TomWhitwell/Mikrophonie/README.md

# Mikrophonie

Design files for the Music Thing Modular Mikrophonie Module.  

Full details available at http://www.musicthing.co.uk
