TomWhitwell/Mikrophonie/Hardware/Mikrophonie_2023/Panel/Kicad/mikrophonie_v2_PCB_proto1.png

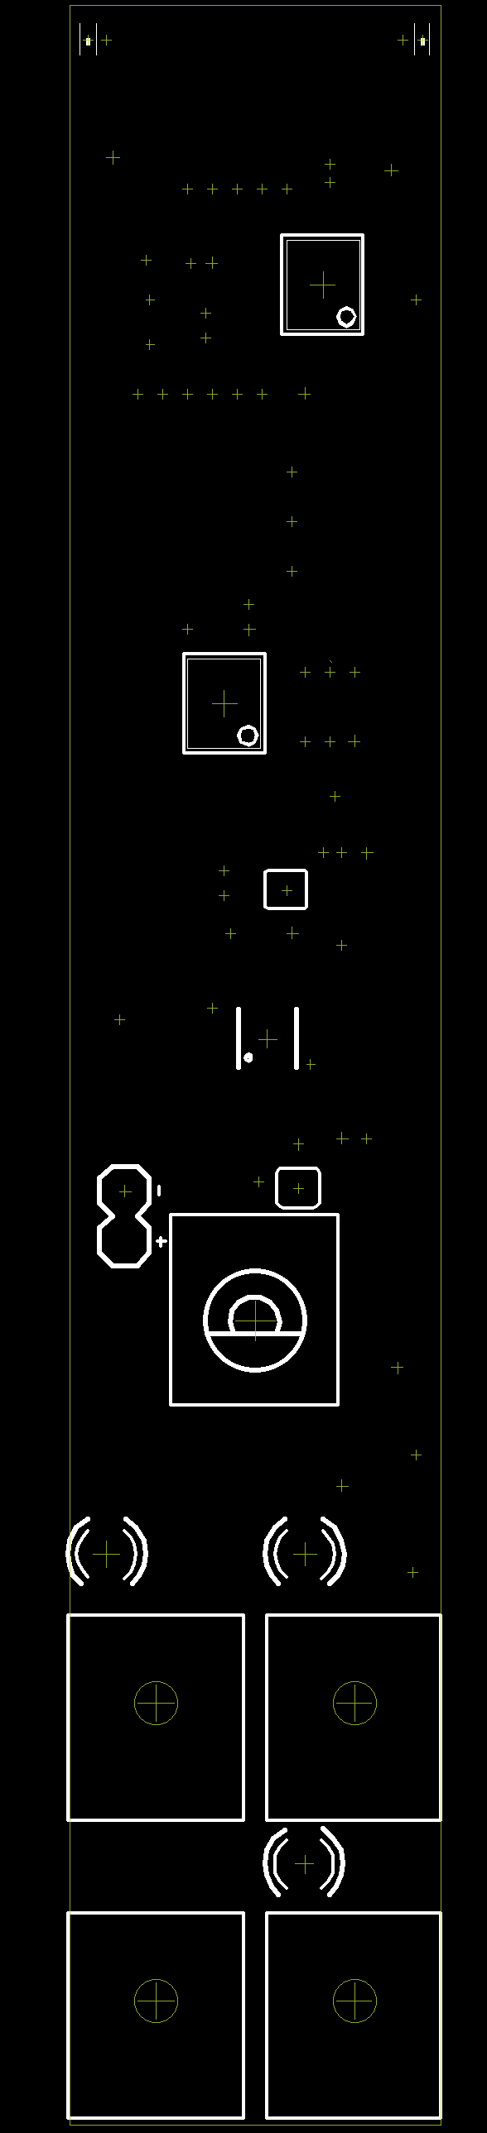
Hardware/Mikrophonie_2023/Panel/Kicad/mikrophonie_v2_PCB_proto1.png
