TomWhitwell/Mikrophonie/Collateral/Mikrophonie-Schematic.pdf

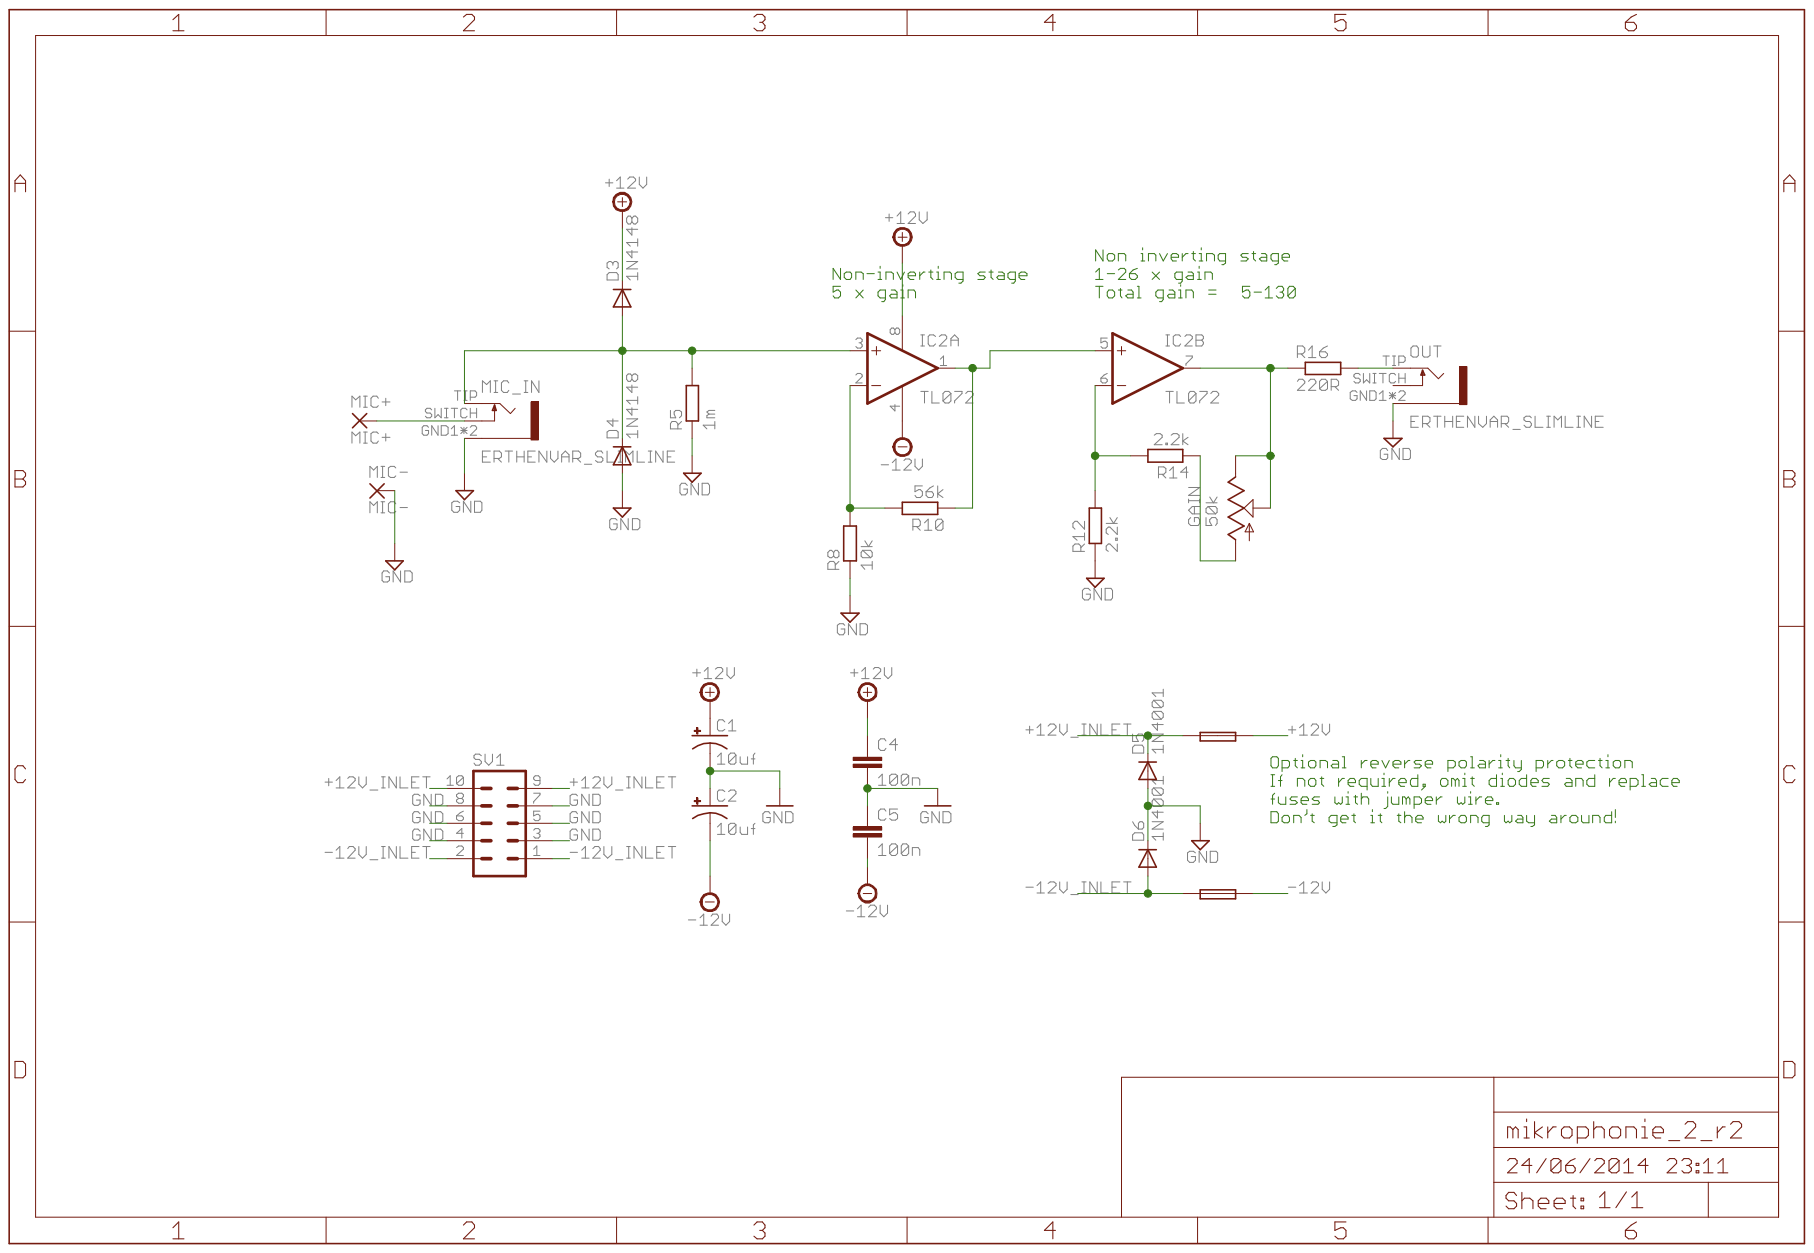
[picture p2: page 1]
