TomWhitwell/Mikrophonie/Hardware/Mikrophonie_2023/mikrophonie_2023-Schematic.pdf

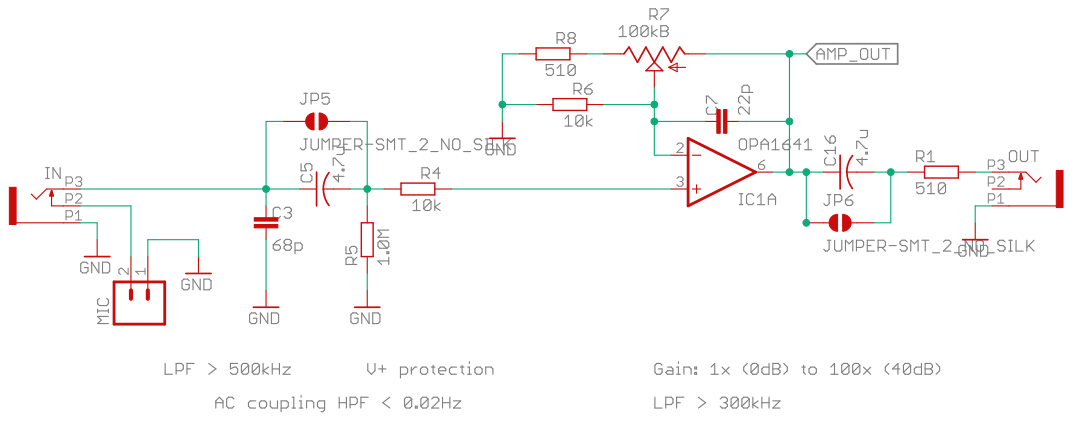
[picture p3: page 1]

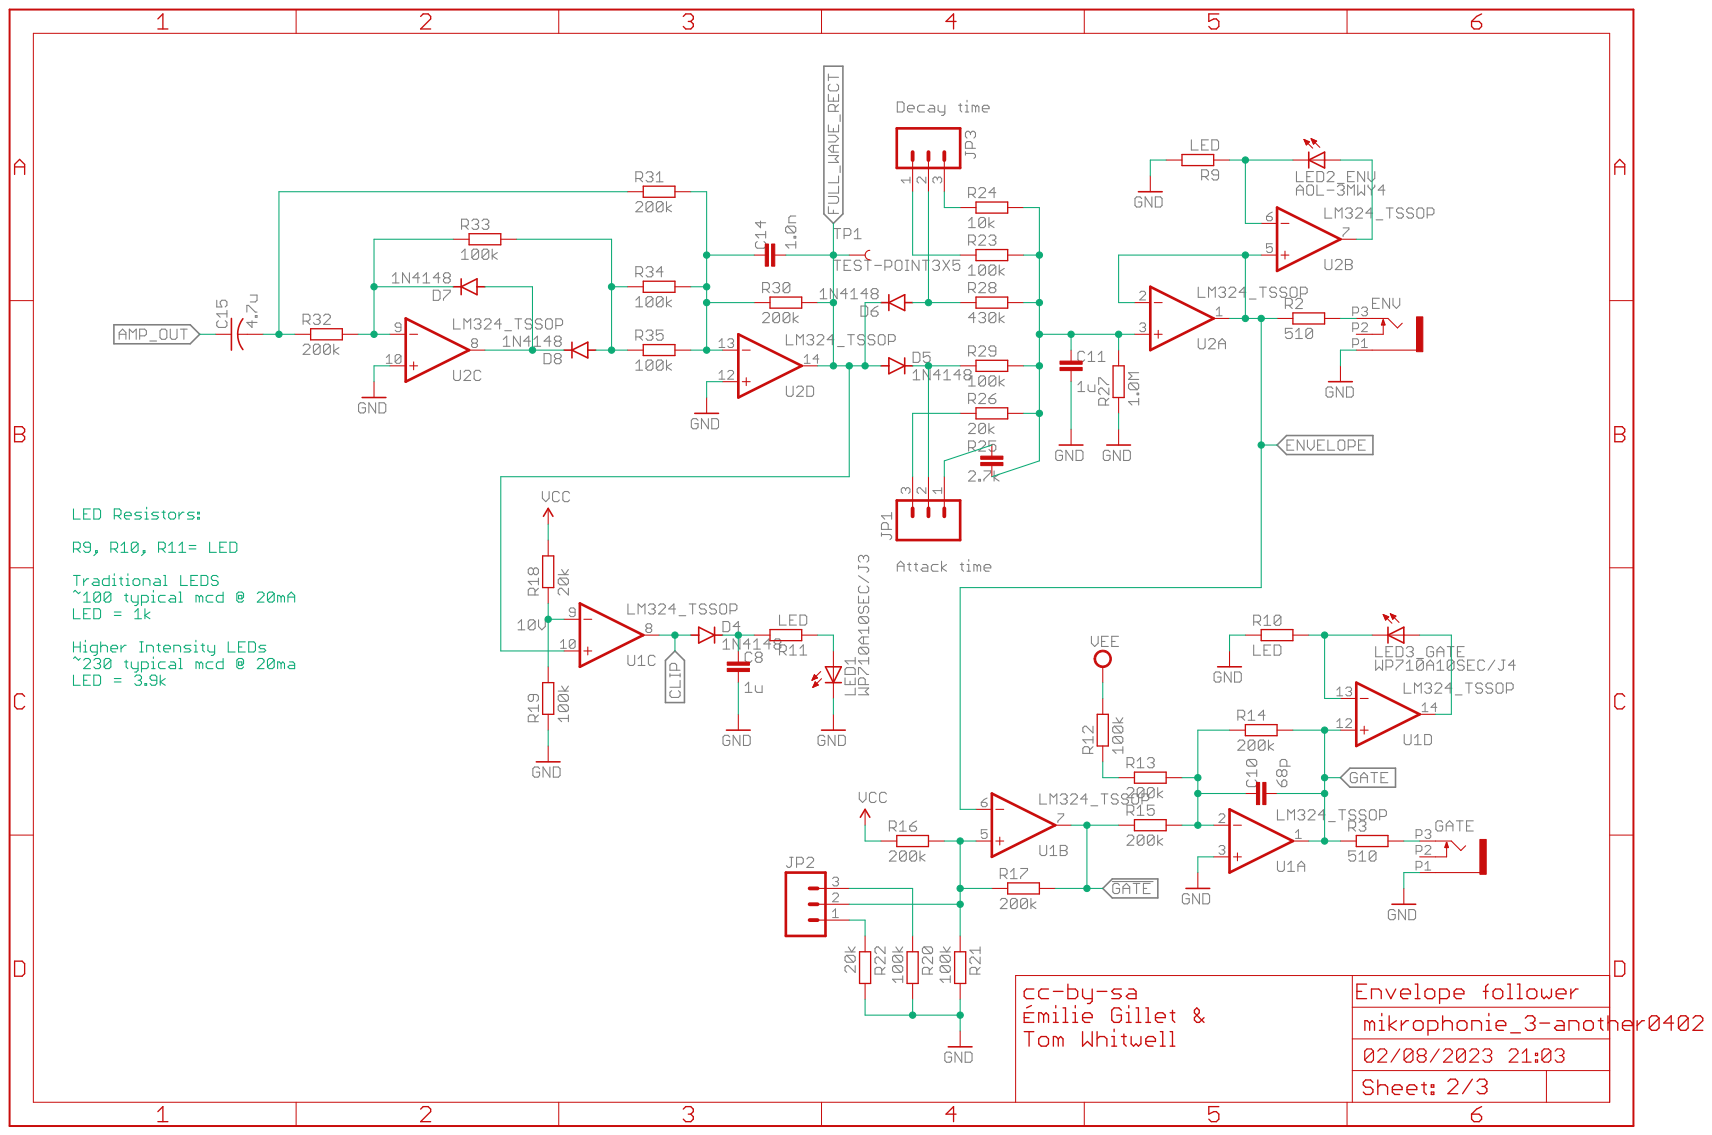
[picture p4: page 2]

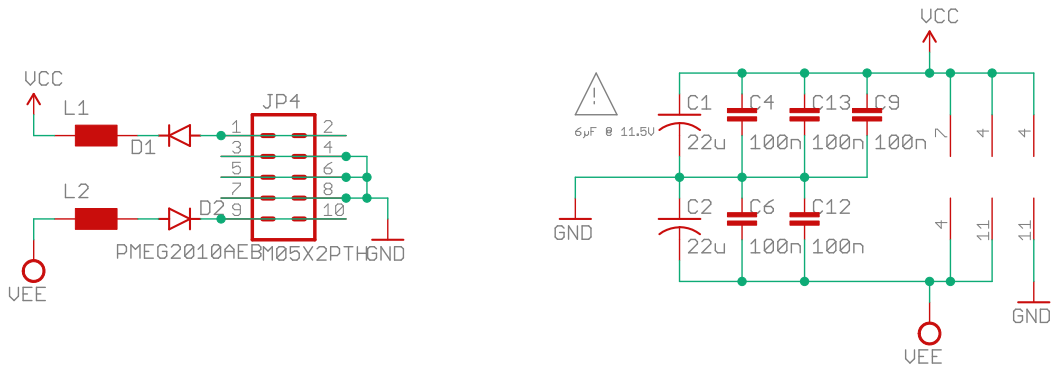
[picture p5: page 3]
