TomWhitwell/Mikrophonie/Hardware/Mikrophonie_2023/mikrophonie_2023.brd

## EAGLE design Hardware/Mikrophonie_2023/mikrophonie_2023.brd (2023-10-18)


Parts:
C3: 68p; C0402-90
C5, C16: 4.7u; C0603
C7: 22p; C0402-90
IC1: OPA1641; MSOP8
IN: PJ301_THONKICONN6; WQP_PJ_301M6
JP5, JP6: JUMPER-SMT_2_NO_SILK; SMT-JUMPER_2_NO_SILK
MIC: M02TINY; 1X02_TINY
OUT: PJ301_THONKICONN6; WQP_PJ_301M6
R1, R8: 510; C0402-90
R4, R6: 10k; C0402-90
R5: 1.0M; C0402-90
R7: 100kB; ALPS_POT_VERTICAL_PS

Connections:
AMP_OUT: C7.2, C16.1, IC1.6 (OUT), JP6.1, R7.P$3 (A); also elsewhere on the board
GND: C3.2, IN.P1 (1), MIC.1, OUT.P1 (1), R5.1, R6.2, R8.2; also elsewhere on the board
unnamed: IC1.3 (+IN), R4.1
unnamed: OUT.P3 (3), R1.2
unnamed: C3.1, C5.1, IN.P3 (3), JP5.1
unnamed: IN.P2 (2), MIC.2
unnamed: C7.1, IC1.2 (-IN), R6.1, R7.P$2 (S)
unnamed: C5.2, JP5.2, R4.2, R5.2
unnamed: R7.P$1 (E), R8.1
unnamed: C16.2, JP6.2, R1.1

Notes on the sheet:
cc-by-sa
Input amplifier
Gain: 1x (0dB) to 100x (40dB)
LPF > 500kHz
V+ protection
LPF > 300kHz
AC coupling HPF < 0.02Hz
Émilie Gillet & Tom Whitwell


Parts:
C8, C11: 1u; C0402-90
C10: 68p; C0402-90
C14: 1.0n; C0402-90
C15: 4.7u; C0603
D4, D5, D6, D7, D8: 1N4148; SOD523
ENV: PJ301_THONKICONN6; WQP_PJ_301M6
GATE: PJ301_THONKICONN6; WQP_PJ_301M6
JP1, JP2, JP3: M03PTH; 1X03
LED1: WP710A10SEC/J3; LED3MM
LED2_ENV: AOL-3MWY4; LED3MM
LED3_GATE: WP710A10SEC/J4; LED3MM
R2, R3: 510; C0402-90
R9, R10, R11: LED; C0402-90
R12, R19, R20, R21, R23, R29, R33, R34, R35: 100k; C0402-90
R13, R14, R15, R16, R17, R30, R31, R32: 200k; C0402-90
R18, R22, R26: 20k; C0402-90
R24: 10k; C0402-90
R25: 2.7k; C0402-90
R27: 1.0M; C0402-90
R28: 430k; C0402-90
TP1: TEST-POINT3X5; PAD.03X.05
U1, U2: LM324_TSSOP; SOP65P640X120-14N

Connections:
!GATE: R15.1, R17.2, U1.7 (OUT)
AMP_OUT: C15.1; also elsewhere on the board
AMP_OUT_AC: C15.2, R31.1, R32.1
CLIP: D4.A, U1.8 (OUT)
ENVELOPE: R2.1, U1.6 (-IN), U2.1 (OUT), U2.2 (-IN), U2.5 (+IN)
FULL_WAVE_RECT: C14.2, D5.A, D6.C, R30.2, TP1.P$1, U1.10 (+IN), U2.14 (OUT)
GATE: C10.2, R3.1, R14.2, U1.1 (OUT), U1.12 (+IN)
GND: C8.2, C11.2, ENV.P1 (1), GATE.P1 (1), LED1.K (C), R9.2, R10.1, R19.1, R20.2, R21.2, R22.2, R27.1, U1.3 (+IN), U2.10 (+IN), U2.12 (+IN); also elsewhere on the board
unnamed: D7.A, D8.C, U2.8 (OUT)
unnamed: C10.1, R13.2, R14.1, R15.2, U1.2 (-IN)
unnamed: D7.C, R32.2, R33.1, U2.9 (-IN)
unnamed: D8.A, R33.2, R34.1, R35.1
unnamed: C14.1, R30.1, R31.2, R34.2, R35.2, U2.13 (-IN)
unnamed: ENV.P3 (3), R2.2
unnamed: LED2_ENV.K (C), R9.1, U2.6 (-IN)
unnamed: D5.C, JP1.2, R29.1
unnamed: C11.1, R23.2, R24.2, R25.2, R26.2, R27.2, R28.2, R29.2, U2.3 (+IN)
unnamed: JP3.3, R24.1
unnamed: JP3.1, R23.1
unnamed: D6.A, JP3.2, R28.1
unnamed: JP1.1, R25.1
unnamed: JP1.3, R26.1
unnamed: R18.1, R19.2, U1.9 (-IN)
unnamed: C8.1, D4.C, R11.2
unnamed: LED2_ENV.A, U2.7 (OUT)
unnamed: LED1.A, R11.1
unnamed: GATE.P3 (3), R3.2
unnamed: JP2.2, R16.2, R17.1, R21.1, U1.5 (+IN)
unnamed: JP2.1, R22.1
unnamed: JP2.3, R20.1
unnamed: LED3_GATE.K (C), R10.2, U1.13 (-IN)
unnamed: LED3_GATE.A, U1.14 (OUT)
unnamed: R12.1, R13.1
VCC: R16.1, R18.2; also elsewhere on the board
VEE: R12.2; also elsewhere on the board

Notes on the sheet:
cc-by-sa
Envelope follower
Decay time
Attack time
10V
Émilie Gillet & Tom Whitwell
LED Resistors: R9, R10, R11= LED Traditional LEDS ~100 typical mcd @ 20mA LED = 1k Higher Intensity LEDs ~230 typical mcd @ 20ma LED = 3.9k


Parts:
C1, C2: 22u; C1206
C4, C6, C9, C12, C13: 100n; C0402-90
D1, D2: PMEG2010AEB; SOD523
IC1: OPA1641; MSOP8
JP4: M05X2PTH; AVR_ICSP
L1, L2: WE-CBF_0603; 0603
U1, U2: LM324_TSSOP; SOP65P640X120-14N

Connections:
GND: C1.2, C2.1, C4.2, C6.1, C9.2, C12.1, C13.2, JP4.3, JP4.4, JP4.5, JP4.6, JP4.7, JP4.8, U1.11 (V-); also elsewhere on the board
unnamed: D1.A, JP4.1, JP4.2
unnamed: D2.C, JP4.9, JP4.10
unnamed: D1.C, L1.2
unnamed: D2.A, L2.2
VCC: C1.1, C4.1, C9.1, C13.1, IC1.7 (V+), L1.1, U1.4 (V+), U2.4 (V+); also elsewhere on the board
VEE: C2.2, C6.2, C12.2, IC1.4 (V-), L2.1, U2.11 (V-); also elsewhere on the board

Notes on the sheet:
cc-by-sa
Power supply
6µF @ 11.5V
Émilie Gillet & Tom Whitwell

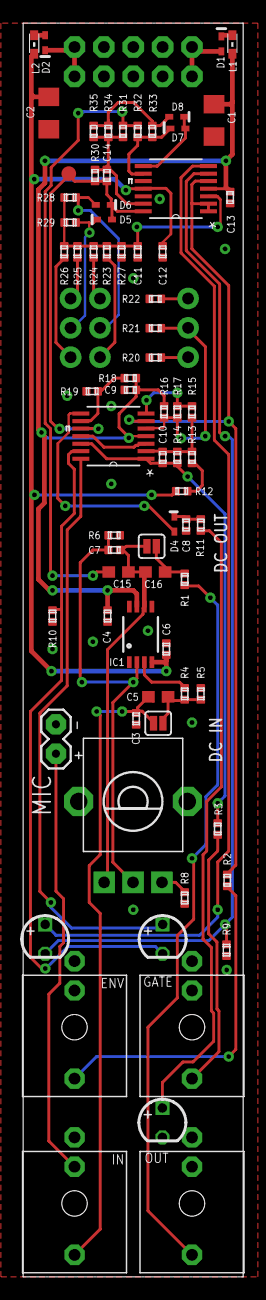
[picture p9: board mikrophonie_2023.brd from above]

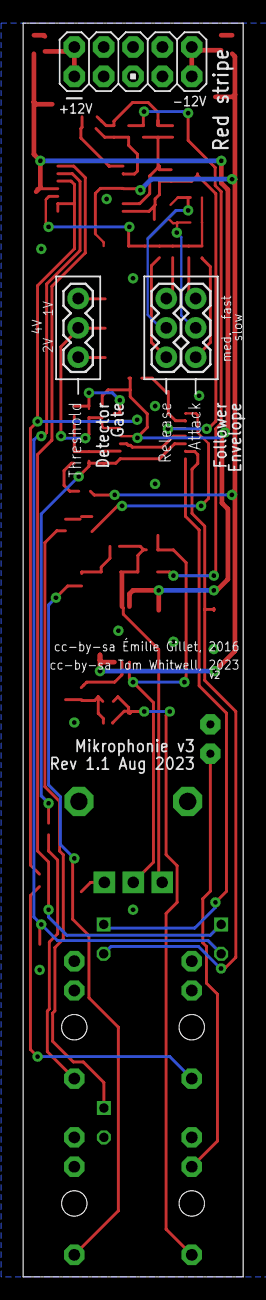
[picture p10: board mikrophonie_2023.brd from below]

Board: 2 copper layers, 19.0 x 108.4 mm, 78 parts (4 on the bottom side), 47 nets.
