TomWhitwell/Mikrophonie/Hardware/Mikrophonie_2014/Mikrophonie_2_2_egl/mikrophonie_2_r2.brd

## EAGLE design Hardware/Mikrophonie_2014/Mikrophonie_2_2_egl/mikrophonie_2_r2.brd (2018-01-01)

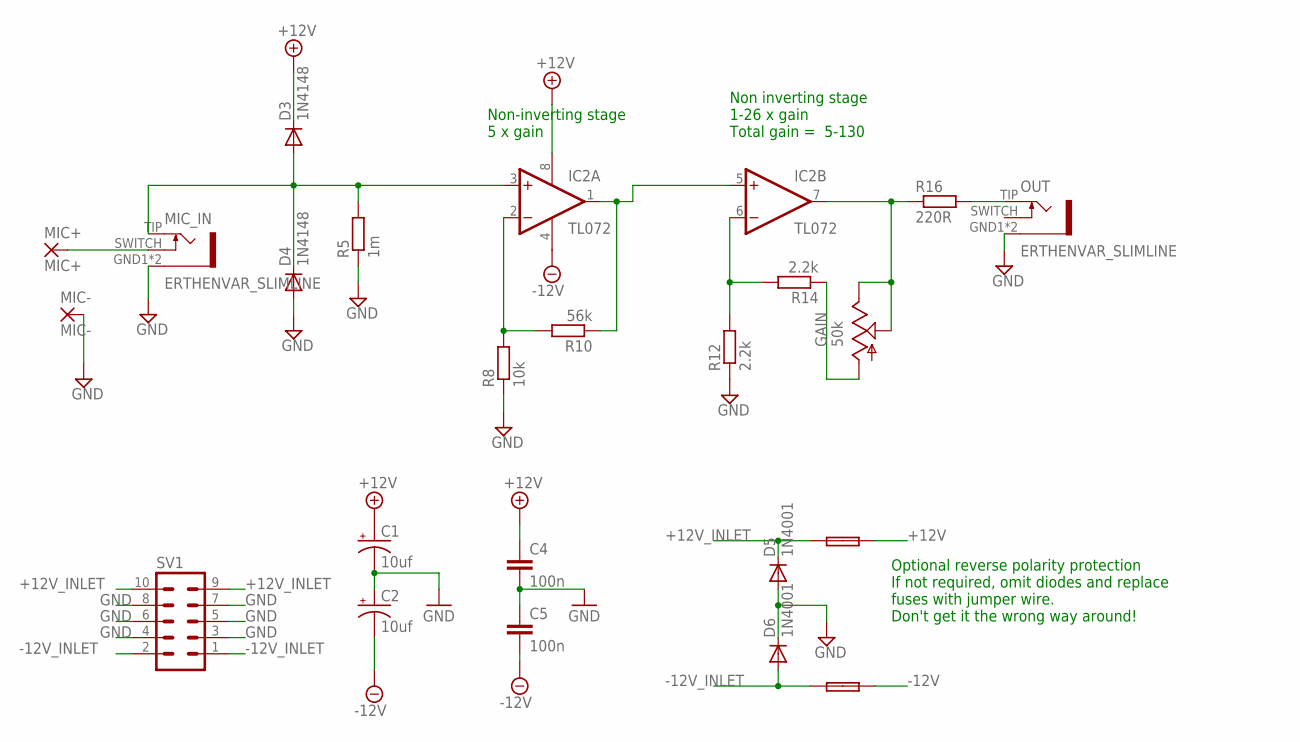
[picture p11: schematic mikrophonie_2_r2.sch]

Parts:
1: FUSE; C050H075X075
C1, C2: 10uf; CPOL-RADIAL-10UF-25V
C4, C5: 100n; C050-024X044
D3, D4: 1N4148; DO35-7
D5, D6: 1N4001; DO41-10
FUSE: FUSE; C050H075X075
GAIN: 50k; EVUF
IC2: TL072; DIL08
MIC+: MIC+; LONG_PAD_1
MIC-: MIC-; LONG_PAD_1
MIC_IN: ERTHENVAR_SLIMLINE
OUT: ERTHENVAR_SLIMLINE
R5: 1m; 0207/10
R8: 10k; 0207/10
R10: 56k; 0207/10
R12, R14: 2.2k; 0207/10
R16: 220R; 0207/10
SV1: 10_PIN_HEADER; MA05-2

Connections:
+12V: 1.2, C1.1 (+), C4.1, D3.C, IC2.8 (V+)
+12V_INLET: 1.1, D5.C, SV1.9, SV1.10
-12V: C2.2 (-), C5.2, FUSE.2, IC2.4 (V-)
-12V_INLET: D6.A, FUSE.1, SV1.1, SV1.2
GND: C1.2 (-), C2.1 (+), C4.2, C5.1, D4.A, D5.A, D6.C, MIC-.P$1, MIC_IN.GND1 (5), MIC_IN.GND2 (5), OUT.GND1 (5), OUT.GND2 (5), R5.1, R8.1, R12.1, SV1.3, SV1.4, SV1.5, SV1.6, SV1.7, SV1.8
unnamed: MIC+.P$1, MIC_IN.SWITCH (4)
unnamed: D3.A, D4.C, IC2.3 (+IN), MIC_IN.TIP (3), R5.2
unnamed: IC2.2 (-IN), R8.2, R10.2
unnamed: IC2.1 (OUT), IC2.5 (+IN), R10.1
unnamed: GAIN.1 (A), R14.1
unnamed: IC2.6 (-IN), R12.2, R14.2
unnamed: GAIN.2 (S), GAIN.3 (E), IC2.7 (OUT), R16.1
unnamed: OUT.TIP (3), R16.2

Notes on the sheet:
Non-inverting stage 5 x gain
Non inverting stage 1-26 x gain Total gain = 5-130
Optional reverse polarity protection If not required, omit diodes and replace fuses with jumper wire. Don't get it the wrong way around!

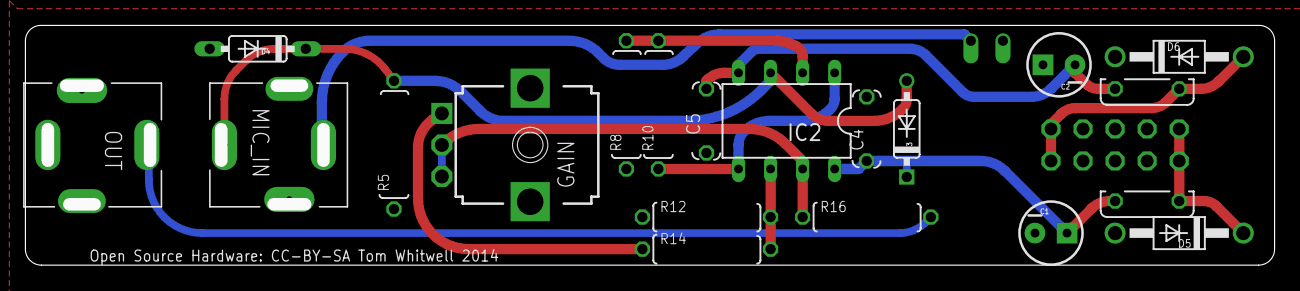
[picture p12: board mikrophonie_2_r2.brd from above]

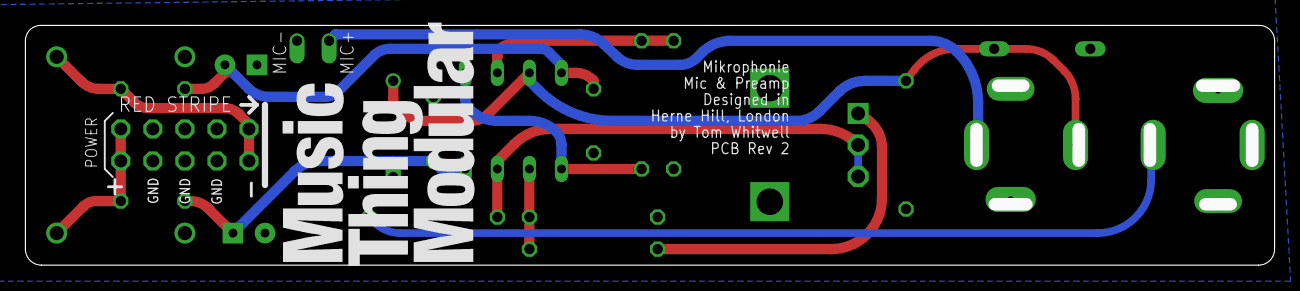
[picture p13: board mikrophonie_2_r2.brd from below]

Board: 4 copper layers, 99.0 x 19.0 mm, 24 parts (2 on the bottom side), 13 nets.

Other parts of the board:
U$2: MTM_2CM_SCREEN_200DPI
