TomWhitwell/Mikrophonie/(threads)

Thread 1 (2022-08-02):

Which type of fuse should be used?

LegendaryTeacherLiu, 2022-08-02:
The model is not marked on the PCB. Can you tell me which model should be useful?

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

benjaminvdb, 2024-12-02:
If you check the module for shorts after building it (continuity between +12/-12, -12/GND or +12/GND means a short) and test the module in isolation (to avoid damaging other modules) then you don't need a fuse, in my opinion. In other words, you can use a wire or clipped lead to short the circuit where the fuse is supposed to go.

The fuse is there as overcurrent protection which is most likely caused by a short. I don't encounter them a lot in Eurorack modules these days. If you really need the additional protection, Radio Music uses [this](https://www.mouser.co.uk/ProductDetail/Bourns/MF-R020?qs=nLE2%252BMMRs0pqW6bjYnf13g%3D%3D) fuse which should definitely work.
