TomWhitwell/Mikrophonie/(notices)

Notices in the files:
Hardware/Mikrophonie_2014/Mikrophonie_2_panel_rev2_egl/mikrophonie_2_panel_rev2.brd:
Open Source Hardware: CC-BY-SA Tom Whitwell 2014
Hardware/Mikrophonie_2023/mikrophonie_2023.brd:
cc-by-sa Émilie Gillet, 2016
cc-by-sa Tom Whitwell, 2023
parts and their libraries:
SparkFun-Passives: Licensing: CC v3.0 Share-Alike You are welcome to use this library for commercial purposes.
SparkFun-Jumpers: Licensing: Creative Commons ShareAlike 4.0 International - https://creativecommons.org/licenses/by-sa/4.0
